BumbleBee363/WATER/z7298331043909_6958153f16be65563165d12b57739341.jpg

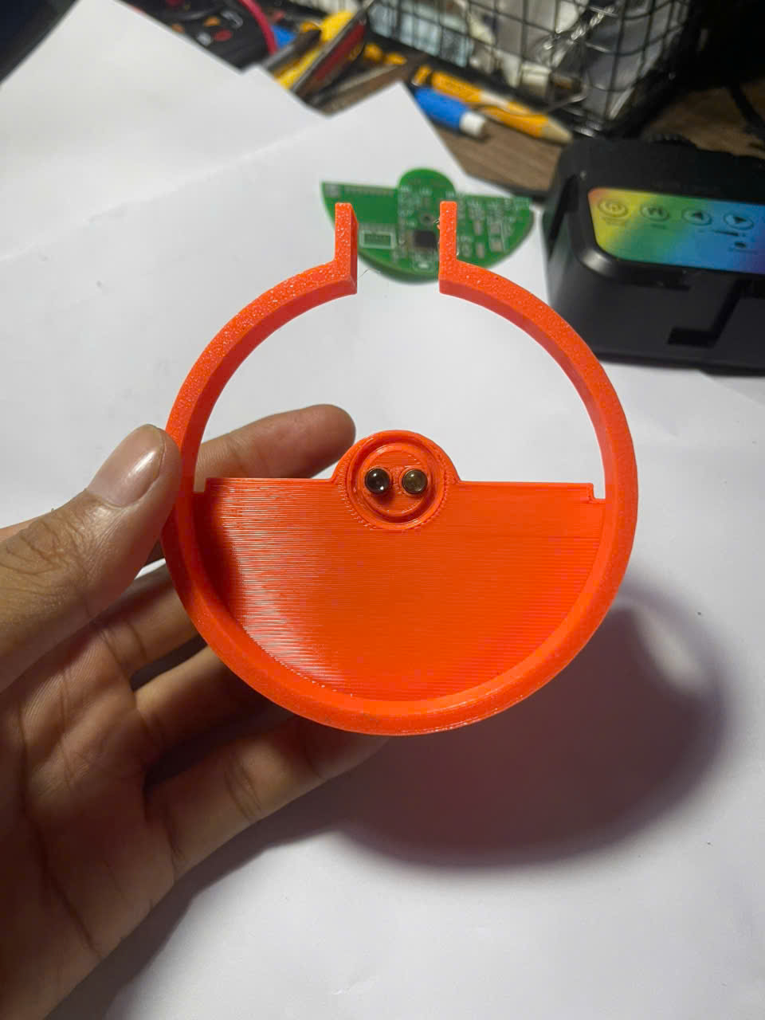
z7298331043909_6958153f16be65563165d12b57739341.jpg
