BumbleBee363/WATER/z7298331055007_0910a80fc175b4dc8d58c2239177b19c.jpg

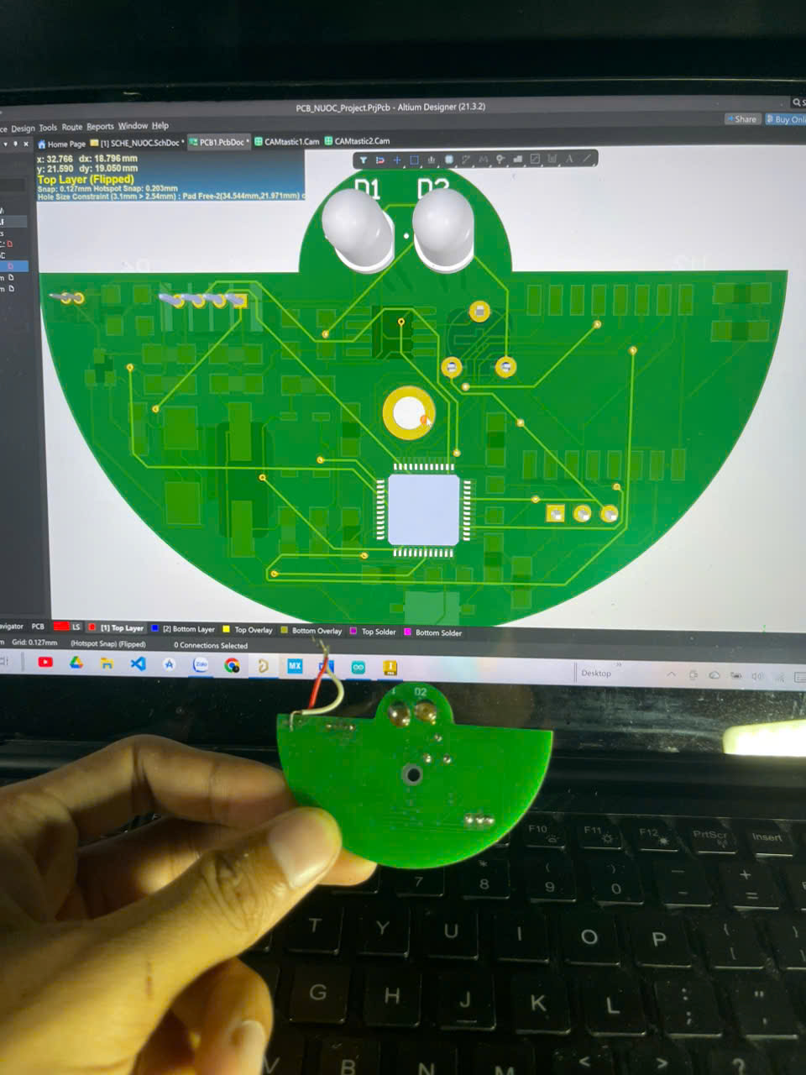
z7298331055007_0910a80fc175b4dc8d58c2239177b19c.jpg
