BumbleBee363/WATER/z7298331054237_fd197ddaf2ae901ba4326b02289347c9.jpg

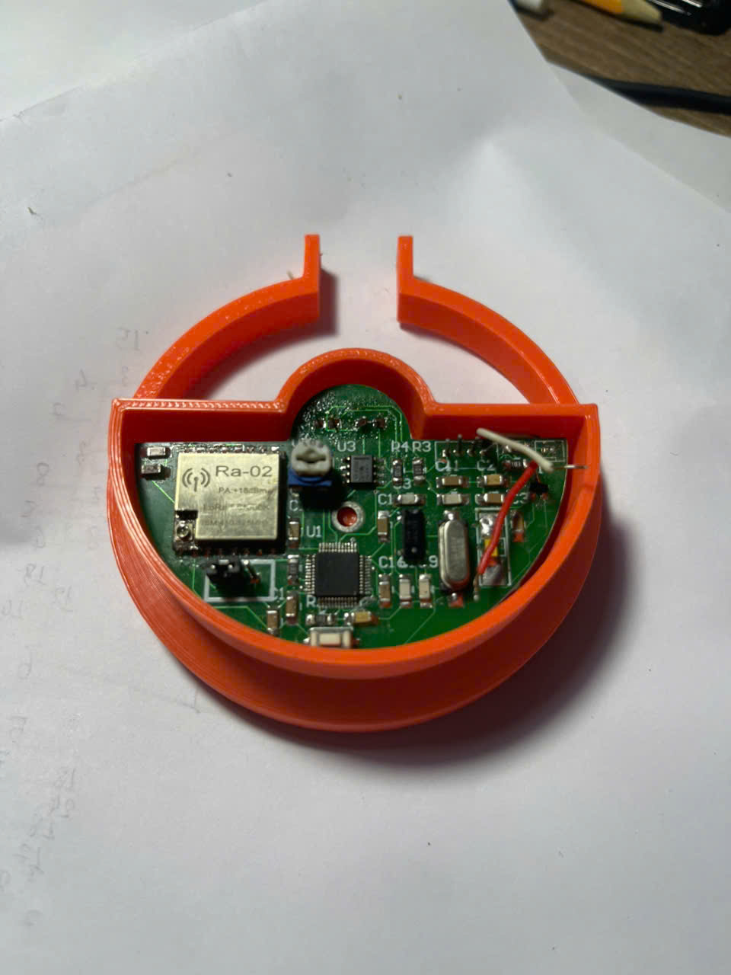
z7298331054237_fd197ddaf2ae901ba4326b02289347c9.jpg
