BumbleBee363/WATER/z7298331063261_b5cdfaaad361a24789f610e0eb0687e9.jpg

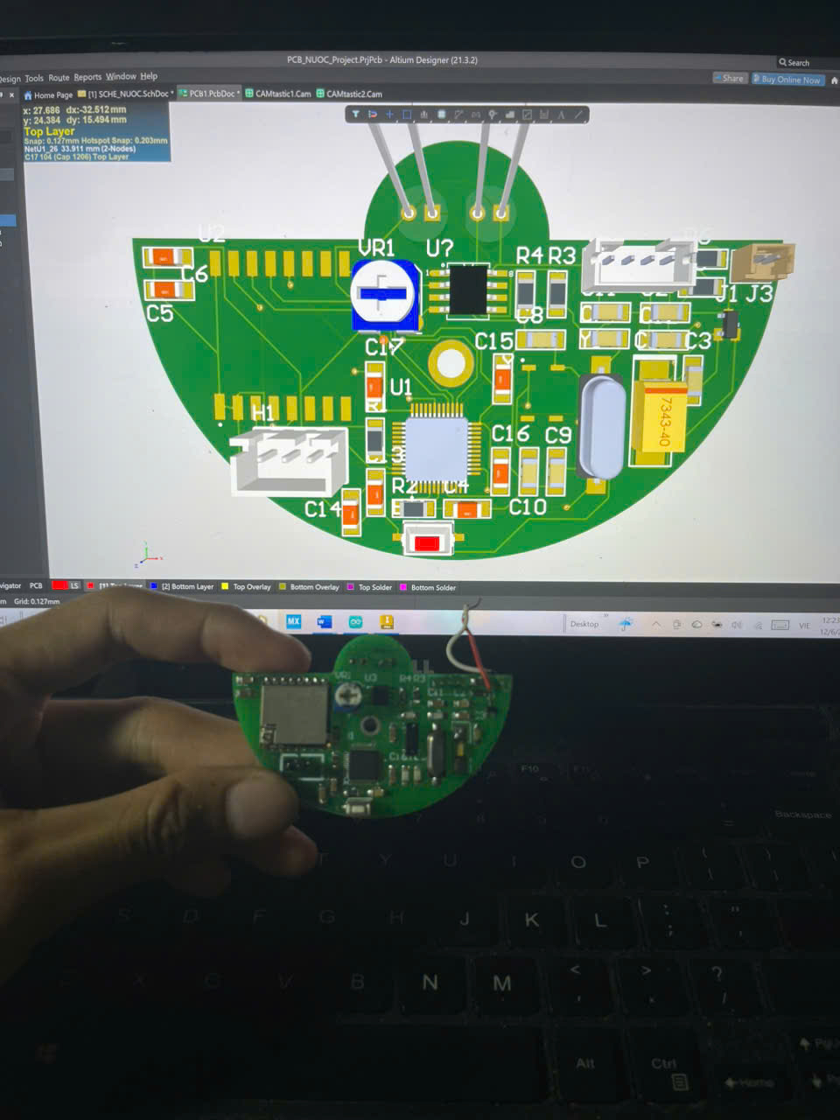
z7298331063261_b5cdfaaad361a24789f610e0eb0687e9.jpg
