BumbleBee363/WATER/z7298331063634_42f681e212fd56c92db5db5b4c0bfc0a.jpg

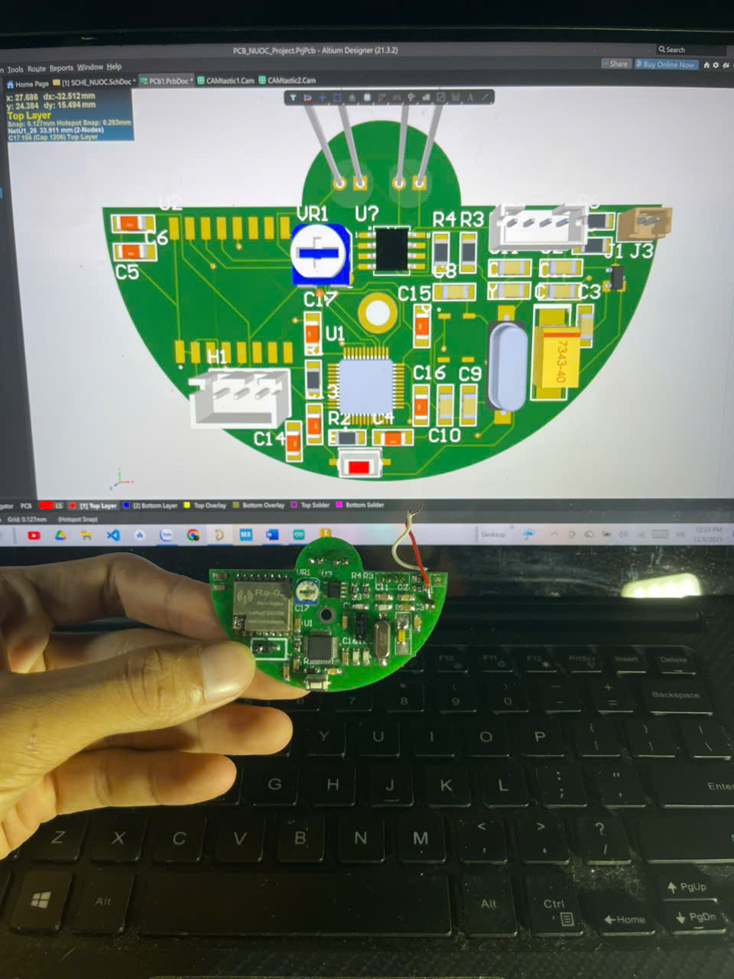
z7298331063634_42f681e212fd56c92db5db5b4c0bfc0a.jpg
