BumbleBee363/WATER/z7298331191239_6b1250fed35b72de4c2acfef4ca6ca26.jpg

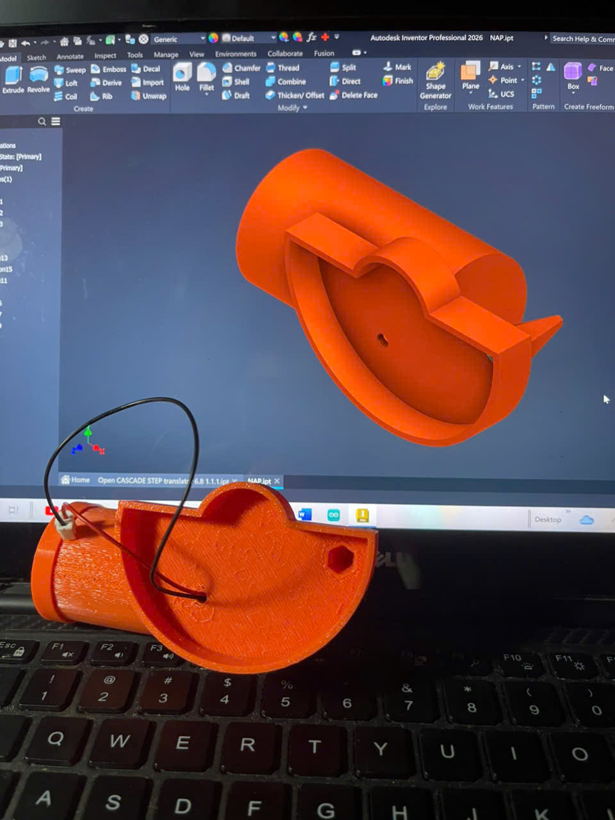
z7298331191239_6b1250fed35b72de4c2acfef4ca6ca26.jpg
