BumbleBee363/WATER/z7298331281841_fd02acd18651171b5184456699a41448.jpg

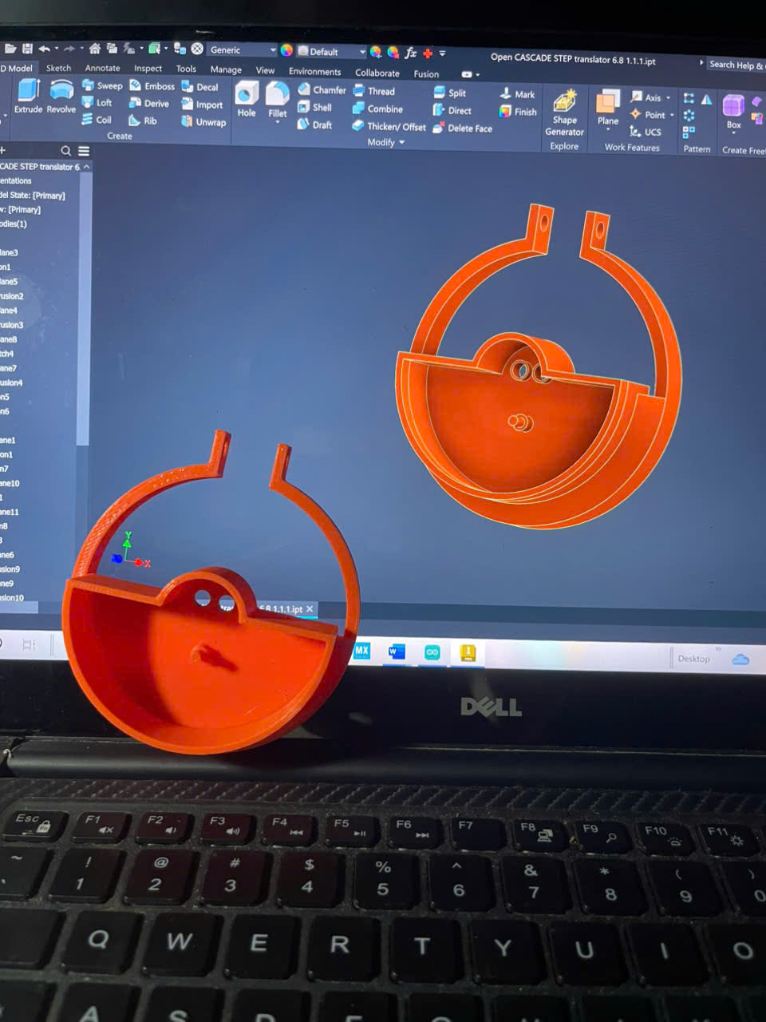
z7298331281841_fd02acd18651171b5184456699a41448.jpg
