BumbleBee363/WATER/z7298331326151_6fe79ca4a0f06991fe03707285752c7c.jpg

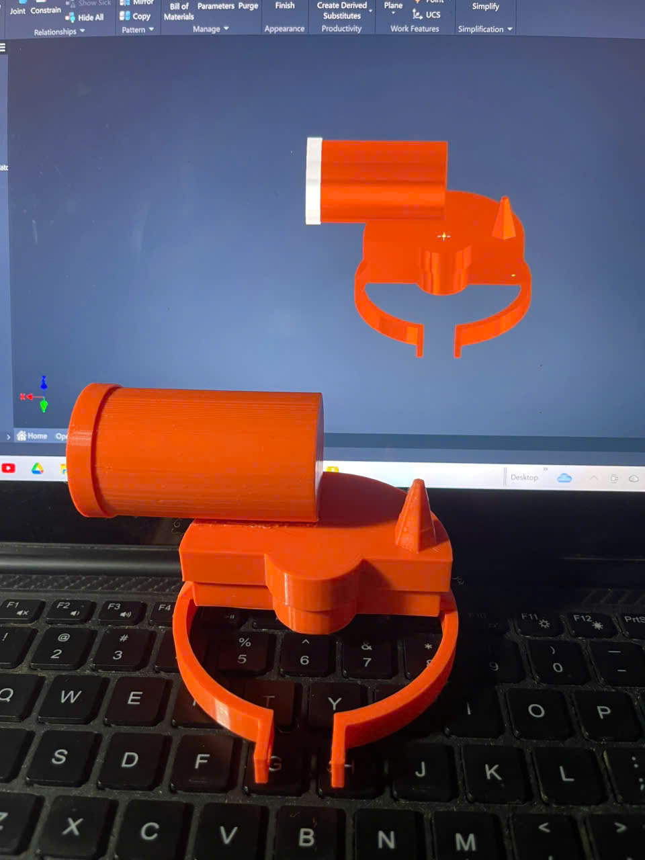
z7298331326151_6fe79ca4a0f06991fe03707285752c7c.jpg
