BumbleBee363/WATER/z7298345396133_22310cba9fd6075292e95550ecaeaf03.jpg

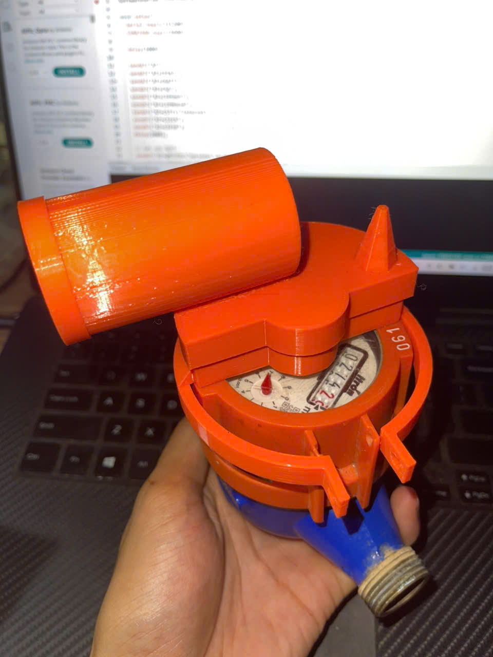
z7298345396133_22310cba9fd6075292e95550ecaeaf03.jpg
