BumbleBee363/WATER/z7298345401848_064a68909a5735fe2c66560c64315763.jpg

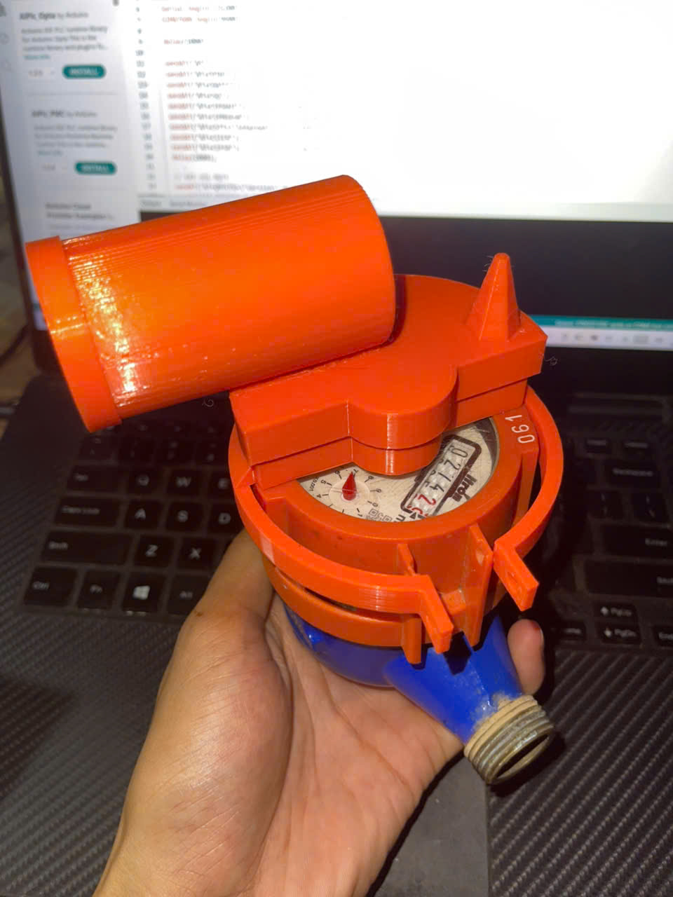
z7298345401848_064a68909a5735fe2c66560c64315763.jpg
