BumbleBee363/WATER/z7298345407363_583b0bc21133c3fb9f5a63aff13930eb.jpg

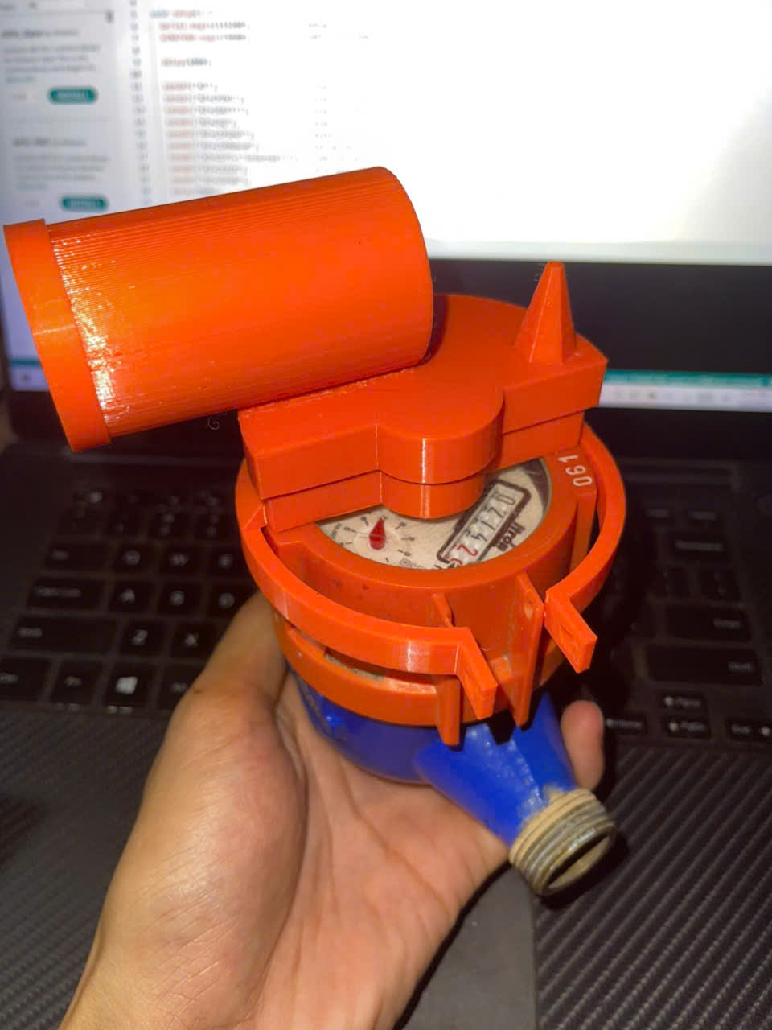
z7298345407363_583b0bc21133c3fb9f5a63aff13930eb.jpg
