BumbleBee363/WATER/z7298345419300_7cee4dae0dac0f6e692878c9aca4c907.jpg

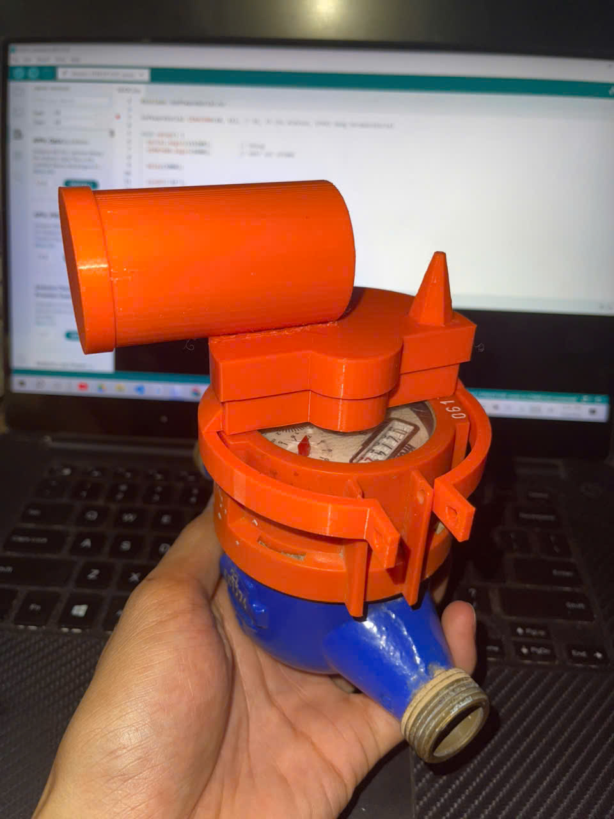
z7298345419300_7cee4dae0dac0f6e692878c9aca4c907.jpg
