BumbleBee363/WATER/(list of files, cad)

Other CAD files:
NAP.dwg
KLTN.dwg
